tytygev/MN-82/справочная/arduino_pro_mini_pinout.gif

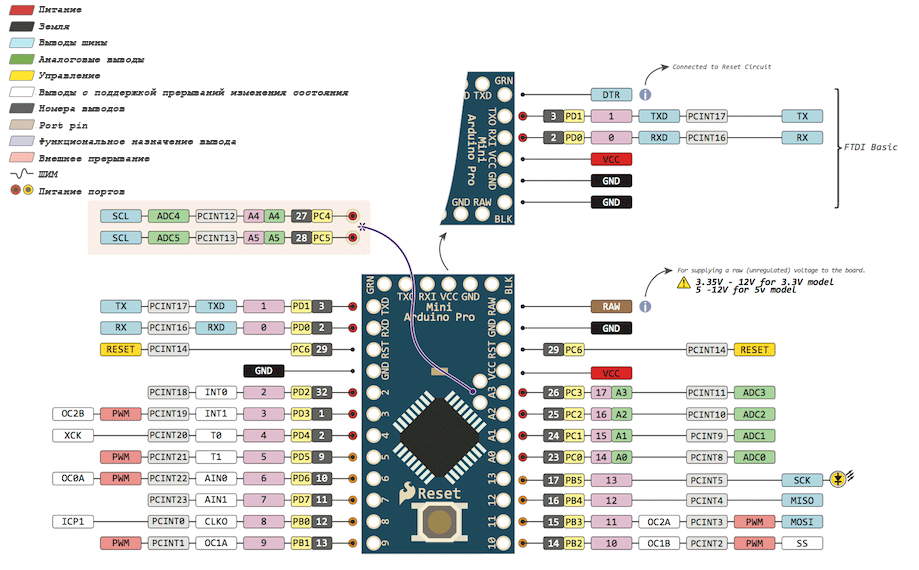
справочная/arduino_pro_mini_pinout.gif
