tytygev/MN-82/MN-82 theory.txt

Доработка радиоуправляемого автомобиля MN-82 на Ардуино Про мини 

Реализую схему управления световым оборудованием
Группы:
Фары (штатная проводка)
ГО задние (питаются от штатной проводки)
ПТФ
Стоп-сигналы
Правый повторитель поворота
Левый повторитель поворота
ЗХ

Ведомость модулей:
0- Штатная плата XL1986RT
1- ардуино с обвесом
2- питание DC5V + RC-модуль (RX480-E-WQ)
3- плата с резисторами для диодных сборк

Штатное питание: 7,4В
Питание ардуино и диодов: 5В. 
Расчётный ток на канал: до 200мА. 

Ввод:
• СИГНАЛЫ ОТ РАДИО МОДУЛЯ НАПРЯМУЮ
• ОТ ПИНОВ МОТОРА ЧЕРЕЗ ДЕЛИТЕЛЬ И ДИОД ЗЕНДЕРА

`
████████████████████████████████
█ Расчёт резисторов для диодов █
████████████████████████████████
`
Питание - 4.8

```
╔═╤═══╤═══════╤═════╤════╤══════╤═════╤═════╗
║◊│ V │ label │ Vcc │side│ A,mA │ R,Ом│Rn,Ом║
╟─┼───┼───────┼─────┼────┼──────┼─────┼─────╢
║ │4.8│ ЗХ    │ 2.7 │ П  │ 3x20 │ 35  │     ║
║ │   │       │     │ Л  │ 3x20 │ 35  │     ║
║ │   │       │     │both│ 6х20 │ 18  │     ║
╟─┼───┼───────┼─────┼────┼──────┼─────┼─────╢
║ │3.3│ ГОзад │ 1.9 │ П  │ 1x20 │ 69  │     ║
║ │   │       │     │ Л  │ 1x20 │ 69  │     ║
║ │   │       │     │both│ 2х20 │ --  │     ║
╟─┼───┼───────┼─────┼────┼──────┼─────┼─────╢
║ │4.8│ СС    │ 2.2 │ П  │ 2x20 │ 65  │     ║
║ │   │       │     │ Л  │ 2x20 │ 65  │     ║
║ │   │       │     │both│ 4х20 │ 32  │     ║
╟─┼───┼───────┼─────┼────┼──────┼─────┼─────╢
║ │4.8│ ППзад │ 2.2 │ П  │ 3x20 │ 43  │     ║
║ │   │       │     │ Л  │ 3x20 │ 43  │     ║
╟─┼───┼───────┼─────┼────┼──────┼─────┼─────╢
║ │4.8│ ППпер │ 2.2 │ П  │ 3x20 │ 43  │     ║
║ │   │       │     │ Л  │ 3x20 │ 43  │     ║
╟─┼───┼───────┼─────┼────┼──────┼─────┼─────╢
║ │4.8│ ППбок │ 1.8 │ П  │ 3x20 │ 50  │     ║
║ │   │       │     │ Л  │ 3x20 │ 50  │     ║
╟─┼───┼───────┼─────┼────┼──────┼─────┼─────╢
║ │4.8│ ПТФ   │ 3.0 │ П  │ 1x40 │ 45  │     ║
║ │   │       │     │ Л  │ 1x40 │ 45  │     ║
║ │   │       │     │both│ 2х40 │ 22  │     ║
╟─┼───┼───────┼─────┼────┼──────┼─────┼─────╢
║ │4.8│ ГС    │ 3.0 │ П  │ 1x30 │ 60  │     ║
║ │   │       │     │ Л  │ 1x30 │ 60  │     ║
║ │   │       │     │both│ 2х60 │ 30  │     ║
╚═╧═══╧═══════╧═════╧════╧══════╧═════╧═════╝
```

Падение напряжения на светодиодах
```
Цвет          │Vf, В
──────────────┼─────────
 Инфракрасный │ 1.9
 Красный      │ 1.6-2.0
 Оранжевый    │ 2.0-2.1
 Желтый       │ 2.1-2.2
 Зеленый      │ 2.2-3.5
 Синий        │ 2.5-3.7
 Фиолетовый   │ 2.8-4.0
 Белый        │ 3.0-3.7
 UV           │ 3.1-4.4
```
рабочий ток светодиода
Для стандартных 5 мм DIP-светодиодов на ножках, это величина обычно равна 20 мА.

`
██████████████████████
█ Управление диодами █
██████████████████████
`
ток до 200 мА на канал
питание 5В
управление по плюсу

лучшим решением является использование PNP биполярных транзисторов. Использование полевых (MOSFET) транзисторов здесь избыточно и усложнит схему, так как P-канальному полевику для полного открытия при 5В нужно так называемое «логическое управление» (Logic Level), а обычные копеечные транзисторы при 5В будут иметь высокое сопротивление.

Биполярный PNP-транзистор BC327-40 (в корпусе TO-92) 
или его SMD-аналог BC807-40 (в корпусе SOT-23) 
Он гарантированно выдерживает ток до 500 мА, коэффициент усиления (hFE) составляет от 250 до 600, что позволяет управлять им напрямую от пина Arduino.
```
                            +5V
                             │
                             ▼
                             │
                    ┌─[ R2 ]─┤   
                    │        │
                    │    ┌───┴───┐
                    │    │   E   │
                    │    │       │
 Arduino ──►─[ R1 ]─┴────┤ B     │
  Пин                    │       │
                         │   C   │
                         └───┬───┘
                             │
                             ▼
                       ┌───────────┐
                       │ Светодиод │
                       │  (Сборка) │
                       └─────┬─────┘
                             │
                             ▼
                           [ R3 ] (токоограничивающий резистор)
                             │
                             ▼
                            GND
```
Спецификация компонентов:

Транзистор: BC327-40 (выводной) или BC807-40 (SMD).
Распиновка BC327 (плоской стороной к себе): Слева направо: C (Коллектор), B (База), E (Эмиттер).
Резистор R1 (Базовый): 1 кОм. 
ток пина Arduino ~3,4 мА
Если будет BC327-25 — нужно подобрать базовый резистор меньшего номинала.
Резистор R2 (pull-up):  10кОм
Резистор R3 (Задающий яркость)

Логика работы (Инверсная): Чтобы светодиоды загорелись, Arduino должна выдать на пин LOW (ноль / земля). Чтобы светодиоды погасли, Arduino должна выдать на пин HIGH (+5V). 

Падение напряжения на транзисторе (Важно для R3!): В режиме насыщения при токе 200 мА падение напряжения между Эмиттером и Коллектором Vce у транзистора BC327 составляет 0.2В. На диодах будет не 5, а 4,8В.

`
███████████████████████████████
█ считывание данных с моторов █
███████████████████████████████
`
Универсальная схема 
(с фильтрацией ШИМ и защитой от выбросов)

Описание работы:
1.  Если ШИМ есть: Конденсатор сглаживает пульсации. Например, если ШИМ идет с заполнением 50% при 8В, то на проводе среднее напряжение будет 4В, а на пин Arduino (после делителя) придет стабильное значение около 1.28В.  
2.  Если ШИМ нет (чистый DC): Конденсатор никак не влияет на постоянный ток, схема работает точно так же, как и в прошлый раз.
3.  Защита от генерации: Стабилитрон и конденсатор работают в паре. Конденсатор берет на себя самые острые и короткие игольчатые импульсы от щеток мотора, а стабилитрон «срезает» лишнее напряжение, если мотор крутанули слишком сильно.

```
Провод X ───[10 kOm]──┬────┬────────┬─── Analog Pin A0
              (R1)    │    │        │   
              (R3)   ┌┴┐  ─┴─     ——┴——  
             4.7 kOm │ │  ─┬─C1     ▲    Стабилитрон D1 (4.7V) 1N4732A
                     └┬┘   │       / \   (Анод к GND, катод к A0)
                      │    │      ——┬—— 
                     GND  GND       │  
                         GND (Общая земля)

-------------------------------------------------------------------------

Провод Y ───[10 kOm]──┬────┬────────┬─── Analog Pin A1
              (R2)    │    │        │   
              (R4)   ┌┴┐  ─┴─     ——┴——  
             4.7 kOm │ │  ─┬─C2     ▲    Стабилитрон D2 (4.7V) 1N4732A
                     └┬┘   │       / \   (Анод к GND, катод к A1)
                      │    │      ——┬—— 
                     GND  GND       │  
                         GND (Общая земля)
```
Спецификация компонентов:
•  2 резистора по 10 кОм (R1, R2)
•  2 резистора по 4.7 кОм (R3, R4)
•  2 керамических или электролитических конденсатора на 0.1 мкФ или 1 мкФ (C1, C2)
•  2 стабилитрона на 4.7В (D1, D2)

 (проверка уровней):
Делитель рассчитан с коэффициентом k = 4.7 / (10 + 4.7) ≈ 0.32.
•  Когда на проводе 8В, на пин Arduino приходит: 8x0.32 = 2.56В.
•  Если мотор крутанули руками, и он выдал, например, 15В выброса: делитель попытался бы выдать 15 x 0.32 = 4.8В. В этот момент стабилитрон открывается и  удерживает напряжение на уровне 4.7В, спасая процессор.

`
█████████████████████████████
█ тахометр на датчике Холла █
█████████████████████████████
`
Датчик A3144 срабатывает на **южный полюс** магнита

Один важный нюанс, который отличает A3144 от многих других датчиков, — это **выход с открытым коллектором (open collector)**. Именно из-за него «голое» подключение может не заработать стабильно, и дело не в самом датчике, а в том, как Arduino читает его сигнал.

Внутри A3144 стоит транзистор, который соединяет выходной пин с землёй, когда видит магнит. Когда магнита нет, выход «висит в воздухе» (высокоимпедансное состояние). Чтобы Arduino могла чётко прочитать логическую единицу, этот «висящий» пин нужно **подтянуть к питанию** через резистор. Без этого пин будет ловить наводки, и `digitalRead()` может выдавать хаос вместо стабильного сигнала.

Технически, у Arduino Pro Mini есть **внутренний подтягивающий резистор** (~20–50 кОм), который включается командой `pinMode(pin, INPUT_PULLUP)` — именно эта команда уже стоит в твоём коде. **С ним датчик, скорее всего, заработает прямо на столе.** Однако внутренний резистор довольно «слабый» (высокое сопротивление), и в реальной модели, где рядом крутится мотор, искрят щётки и гуляют токи, он может не справиться с помехами. Поэтому **внешний резистор — это не обязательное, но крайне желательное усиление помехоустойчивости**.

Рекомендуемый «обвес» для датчиков стоящих на шасси рядом с силовой проводкой:
1.  Подтягивающий резистор 10 кОм между сигнальным пином и VCC 
    Это классическое решение для A3144. Он гарантирует, что в отсутствие магнита Arduino видит чёткую «1», а не наведённый шум.
2.  Керамический конденсатор 0.1 мкФ между сигнальным пином и GND
    Он работает как маленький фильтр, сглаживая высокочастотные помехи от мотора. 
	
Итоговая схема подключения для каждого датчика:
Нога 1 (VCC): к +5В.
Нога 2 (GND): к земле (GND).
Нога 3 (OUT): к пину Arduino (A1 или A2), и параллельно:
    *Резистор 10 кОм между этой ногой и +5В.
    *Конденсатор 0.1 мкФ между этой ногой и GND.

В коде команду `INPUT_PULLUP` можно оставить — она не помешает, а внешний резистор возьмёт на себя основную работу по подтяжке.

`
██████████████████████████████████████████
█ получение данных от внешнего приёмника █
██████████████████████████████████████████
`
RX480-E-WQ — это компактный 4-канальный беспроводной супергетеродинный радиоприемник, работающий на частоте 433 МГц (редко 315 МГц) с поддержкой кодировки EV1527. Он принимает сигналы от пультов ДУ и выдает управляющие сигналы на четырех независимых цифровых выходах (D0–D3).
Согласование не требуется.

Характеристики и распиновка
Напряжение питания: от 3,0 В до 5,0 В постоянного тока.
Частота: 433,92 МГц (или 315 МГц).
Выходы: 4 канала (D0, D1, D2, D3) с логическим уровнем.
вывод VT (выход индикации статуса приема, выдает HIGH, когда нажата любая кнопка на пульте)
Питание и земля: контакты +V (VCC) и GND.
Антенна: контакт для припайки куска провода (обязателен для стабильного приема).

Режимы работы и настройка
Модуль поддерживает три основных режима работы, которые переключаются кнопкой обучения (Learning Key) на плате:

Импульсный режим (Inching / Momentary): сигнал на выходе D держится только пока зажата кнопка на пульте.
Настройка: нажмите кнопку обучения 1 раз, дождитесь загорания светодиода, затем нажмите кнопку на пульте.

Режим с фиксацией (Self-locking / Toggle): первое нажатие включат канал (высокий уровень), повторное — выключает.
Настройка: нажмите кнопку обучения 2 раза, затем нажмите кнопку на пульте.

Режим блокировки (Interlocking): при включении одного канала другой активный канал выключается.
Настройка: нажмите кнопку обучения 3 раза, затем нажмите кнопку на пульте.Сброс памяти: нажмите кнопку обучения 8 раз, чтобы очистить все привязанные пульты.

`
██████████████
█  ПРОШИВКА  █
██████████████
`
USB-UART на CP2102

Распиновка Pro Mini (обычно 6-контактный разъём для программирования)

• VCC – питание (5 В для вашей версии)
• GND – общий
• RXI (или RX) – вход последовательного порта (подключается к TXD адаптера)
• TXO (или TX) – выход последовательного порта (подключается к RXD адаптера)
• DTR (или GRN) – управление сбросом (если есть отдельный пин)
• RESET – можно использовать при отсутствии DTR

Подключение CP2102 → Pro Mini
```
╔════════╤══════════╤═══════════════════════════════════════════════════════╗
║ CP2102 │ Pro Mini │ Примечание                                            ║
╟────────┼──────────┼───────────────────────────────────────────────────────╢
║ TXD    │ RXI (RX) │ Передача данных от адаптера к микроконтроллеру        ║
║ RXD    │ TXO (TX) │ Приём данных от микроконтроллера                      ║
║ GND    │ GND      │ Обязательно общий провод                              ║
║ +5V    │ VCC      │ Питание Pro Mini от USB (если нет внешнего питания)   ║
║ DTR    │ DTR / GRN│ Если есть выделенный пин DTR/GRN, подключайте напрямую║
║ или    │          │                                                       ║
║ DTR    │ RESET    │ через конденсатор 0.1 мкФ (100 нФ)  Если нет пина DTR,║
║        │          │ используйте конденсатор для автосброса                ║
╚════════╧══════════╧═══════════════════════════════════════════════════════╝
```
Важно: не подключайте вывод 3V3 к 5В плате Pro Mini — это может вывести её из строя. 
Все остальные сигналы (DCD, DSR, RTS, CTS, RST, R1, SUS) не используются, оставьте их неподключёнными.
Автосброс

Для загрузки скетча Arduino IDE автоматически переключает линию DTR, что через конденсатор создаёт импульс сброса на RESET Pro Mini. Если у вас на Pro Mini есть отдельный пин DTR (часто помечен как GRN), соединение напрямую будет работать без дополнительного конденсатора, т.к. на плате уже предусмотрен конденсатор.
Если же вы подключаете DTR к RESET, обязательно поставьте конденсатор 0.1 мкФ (керамический, полярность не важна). Без него сброс может происходить некорректно или вообще не срабатывать.

> Настройка Arduino IDE
>> Подключите адаптер к USB-порту компьютера.
>> В Arduino IDE выберите:
>>> Инструменты → Плата → Arduino Pro or Pro Mini
>>> Процессор → ATmega168P (5V, 16 MHz) (или аналогичный с пометкой 168P)
>> Выберите порт, который появится в Инструменты → Порт (обычно COMx).
> Нажмите «Загрузка».

Если загрузка не удаётся
- Проверьте, что TXD адаптера соединён именно с RXI Pro Mini, а RXD — с TXO (перекрёстно).
- Убедитесь, что GND общий.
- Попробуйте нажать кнопку RESET на Pro Mini сразу после нажатия кнопки «Загрузка» в Arduino IDE (если нет автосброса).
- Проверьте, что питание 5 В подаётся на VCC Pro Mini (если плата не питается отдельно).
- Если прошивка зависает на «Uploading...», возможно, не работает DTR. Тогда вручную удерживайте RESET, запустите загрузку и отпустите RESET через пару секунд.

После этих шагов скетч должен успешно загрузиться в вашу Pro Mini.

`
████████████████████████████████████
█ ТАЙМИНГИ НА ПОВОРОТНИКИ/АВАРИЙКУ █
████████████████████████████████████
`
Согласно ГОСТ Р 41.48 (Правила ЕЭК ООН № 48), соотношение времени работы и паузы должно быть стабильным:
• Свет горит: от 40% до 60% времени одного полного цикла.
• Свет погашен: от 40% до 60% времени одного полного цикла.
Если перевести это в секунды для стандартной частоты (возьмем средние 90 миганий в минуту, где один полный цикл «вспышка + пауза» длится около 0,66 секунды):
• Время свечения: примерно 0,27–0,40 секунды.
• Время темноты: примерно 0,27–0,40 секунды.
Вспышка и пауза на исправном автомобиле визуально должны быть практически одинаковыми по длительности. При первом включении аварийной сигнализации световой сигнал должен загореться не позднее чем через 1 секунду.

`
████████████████████████████████████████
█ Модификация питания и автоотключения █
████████████████████████████████████████
`
1. Общая концепция и логика работы
Система предназначена для полного обесточивания штатной платы (XL1986RT), Arduino Pro Mini, радиоприемника (RX480-E-WQ) и DC-DC преобразователя по истечении заданного времени бездействия. 

Ключевая особенность:
Повторный запуск возможен только после перевода выключателя в положение OFF и обратно в ON. Быстрое «передергивание» (менее 0.5 сек) не сработает, если не установлен диод быстрого разряда (см. пункт 3).

Логика по состояниям:
(1) Включение (Switch ON):
    Питание 7.4В подается на Исток P-MOSFET (Q1). Конденсатор C2 разряжен, Затвор Q1 = 0В. Q1 открывается. Arduino стартует, подает HIGH на пин PIN_HOLD. Транзистор Q2 открывается и прижимает Затвор Q1 к земле, удерживая систему включенной.

(2) Рабочий режим:
    Штатная плата работает от 7.4В. Arduino и RX480 работают от 5В (DC-DC). Arduino управляет светом и моторами.

(3) Автоотключение (по таймауту): 
    Arduino подает LOW на PIN_HOLD. Q2 закрывается. Резистор R2 (1 МОм) плавно заряжает C2, подтягивая Затвор Q1 к Истоку (7.4В). Q1 закрывается. Питание 7.4В полностью пропадает со всей системы. Потребление от батареи = 0А.

(4) Сброс (Switch OFF -> ON): 
    При переводе в OFF центральный контакт кнопки соединяется с левым (GND). Исток Q1 садится на землю. Затвор Q1 (заряженный) через диод D1 мгновенно разряжается на землю. При переводе в ON система запускается с нуля.

2. Спецификация элементов (BOM)

```
╔════╤════════════════════╤══════════════════════════╤════════════════════════════════════╗
║ П. │     Компонент      │   Номинал / Маркировка   │             Примечание             ║
╠════╪════════════════════╪══════════════════════════╪════════════════════════════════════╣
║ Q1 │ P-канальный MOSFET │ IRF9Z34N                 │ Корпус TO-220. Обязательно         ║
║    │                    │ (или аналог Logic-Level) │ Logic-Level (открывается при 4-5В) ║
║ Q2 │ NPN Транзистор     │ 2N3904 (или BC547,S8050) │ Корпус TO-92                       ║
║ D1 │ Диод               │ 1N4148 (или 1N4007)      │ Для быстрого разряда C2            ║
║ R1 │ Резистор           │ 10 кОм (1/4 Вт)          │ Разрядный резистор для левого      ║
║    │                    │                          │ контакта кнопки                    ║
║ R2 │ Резистор           │ 1 МОм (1/4 Вт)           │ Подтяжка Затвора Q1 к Истоку       ║
║ R3 │ Резистор           │ 1 кОм (1/4 Вт)           │ Базовый резистор Q2                ║
║ C2 │ Конденсатор        │ 100 мкФ x 16В            │ Электролитический.                 ║
║    │                    │                          │ Обеспечивает задержку старта       ║
╚════╧════════════════════╧══════════════════════════╧════════════════════════════════════╝
```
3. Описание соединений (Pin-to-Pin)

□ Силовая часть (7.4В)
Батарея B+ -> Правый контакт выключателя (Pin 3)
Правый контакт выключателя (Pin 3) -> Исток (Source) Q1
Сток (Drain) Q1 -> Питание штатной платы XL1986RT (7.4В) + Вход Vin DC-DC
Батарея GND -> GND штатной платы, GND DC-DC, GND Arduino, GND RX480

□ Выключатель (SPDT, 3 контакта)
Правый (Pin 3) -> B+ батареи
Центральный (Pin 2) -> Исток (Source) Q1
Левый (Pin 1) -> Резистор R1 (10 кОм) -> GND

□ Узел удержания и задержки (Затвор Q1)
Затвор (Gate) Q1 -> Резистор R2 (1 МОм) -> Исток (Source) Q1
Затвор (Gate) Q1 -> Плюсовая ножка конденсатора C2 (100 мкФ). Минусовая ножка -> GND
Затвор (Gate) Q1 -> Коллектор NPN-транзистора Q2
Затвор (Gate) Q1 -> Анод диода D1
Катод диода D1 -> Исток (Source) Q1 (то есть параллельно R2)

□ Управление от Arduino
Arduino PIN_HOLD (любой цифровой пин) -> Резистор R3 (1 кОм) -> База NPN-транзистора Q2
Эмиттер NPN-транзистора Q2 -> GND

□ Питание логики (5В)
DC-DC Vin -> Сток (Drain) Q1
DC-DC GND -> GND
DC-DC 5V Out -> Arduino VCC, RX480 VCC
DC-DC En -> Перемычка на Vin (см. важное примечание 1)

4. Важные примечания для реализации

★ Защита пина En DC-DC: 
   Если ваш модуль DC-DC не рассчитан на подачу 8.4В напрямую на пин En (максимум обычно 5-6В), не соединяйте En с Vin напрямую. Поставьте делитель напряжения: резистор 10 кОм от Vin к En и резистор 20 кОм от En к GND. Это снизит напряжение на En до безопасных ~5.6В при полном заряде батареи.

★ Логика скетча Arduino:
   *В блоке setup(): Сразу подать HIGH на PIN_HOLD (чтобы удержать питание после загрузки).
   *В блоке loop(): Отслеживать таймер бездействия. При достижении таймаута подать LOW на PIN_HOLD.

★ Нагрев Q1:
   IRF9Z34N рассчитан на ток до 19А. Если моторы потребляют большой ток (например, при заклинивании), MOSFET может греться. Рекомендуется установить небольшой радиатор

★ Диапазон напряжений:
   Схема работоспособна от 4В до 9В. При 4-5В убедитесь, что DC-DC справляется с выдачей 5В и 300 мА. При 8-9В следите за нагревом DC-DC и защитой пина En.

`
████████████████████████████████████
█ Описание библиотеки PowerManager █
████████████████████████████████████
`
Логика архитектуры
	Интерфейс и конфигурация
		Класс PowerManager
			В конструкторе класса предусмотрена передача всех пинов и их активных уровней
			Неограниченное количество пинов с разными уровнями: реализуем через передачу массива структур InputPin в конструктор.		
			Время таймаута в миллисекундах.

	Реализация логики ввода/вывода
		Метод инициализации begin() — настраивает пины и сразу подает активный уровень на PIN_HOLD для фиксации питания.
		Метод update() — вызывается в основном цикле loop(). Он будет опрашивать входы. Если зафиксирован активный сигнал (с учетом заданного уровня), таймер сбрасывается.

	Логика таймера и состояния 
		Внутренний учет времени через millis().
		Если в течение заданного времени update() не фиксирует активности, класс переходит в состояние подготовки к выключению.
		Реализация метода shutdown() — переводит пин удержания в неактивный уровень (LOW) и, при необходимости, вызывает пользовательский коллбэк.

	Структура файлов (Разделение для переиспользования)
		PowerManager.h — декларация класса, интерфейсы, конфигурация.
		PowerManager.cpp — реализация методов, работа с millis(), чтение пинов и управление выходом.
		В основном .ino файле создание экземпляра класса с нужными настройками и вызов двух методов: power.begin() в setup() и power.update() в loop().

пример использования: 

#include "PowerManager.h"

// Настройки пинов
#define PIN_HOLD D13
#define PIN_RC   D12
#define PIN_HALL_1 A1
#define PIN_HALL_2 A2

// Конфигурация входов
// 1. RC-модуль: активный HIGH, обычный INPUT
// 2. Датчики Холла: активный LOW, INPUT_PULLUP (чтобы не висел в воздухе)
const InputPin inputs[] = {
  {PIN_RC,     HIGH, INPUT},
  {PIN_HALL_1, LOW,  INPUT_PULLUP},
  {PIN_HALL_2, LOW,  INPUT_PULLUP}
};
const uint8_t inputCount = sizeof(inputs) / sizeof(inputs[0]);

// Настройки питания: удержание HIGH на D13, таймаут 5 минут (300000 мс)
PowerManager power(PIN_HOLD, HIGH, inputs, inputCount, 300000);

// (Необязательно) Коллбэк для выполнения перед выключением
void onPowerOff() {
  // Например, выключить свет или мигнуть фарами
  // digitalWrite(PIN_LIGHTS, LOW);
}

void setup() {
  // Инициализация менеджера питания должна быть ПЕРВОЙ
  power.setShutdownCallback(onPowerOff);
  power.begin();

  // ... остальная инициализация ...
}

void loop() {
  // Опрос датчиков и таймера
  power.update();

  // ... основной код ...
}

─│┌┐└┘├┤┬┴┼═║╒╓╔╕╖╗╘╙╚╛╜╝╞╟╠╡╢╣╤╥╦╧╨╩╪╫╬█░▒▓▲►▼◄
