tytygev/MN-82/MN-82 KeyHoldPower with DC5v_схема.png

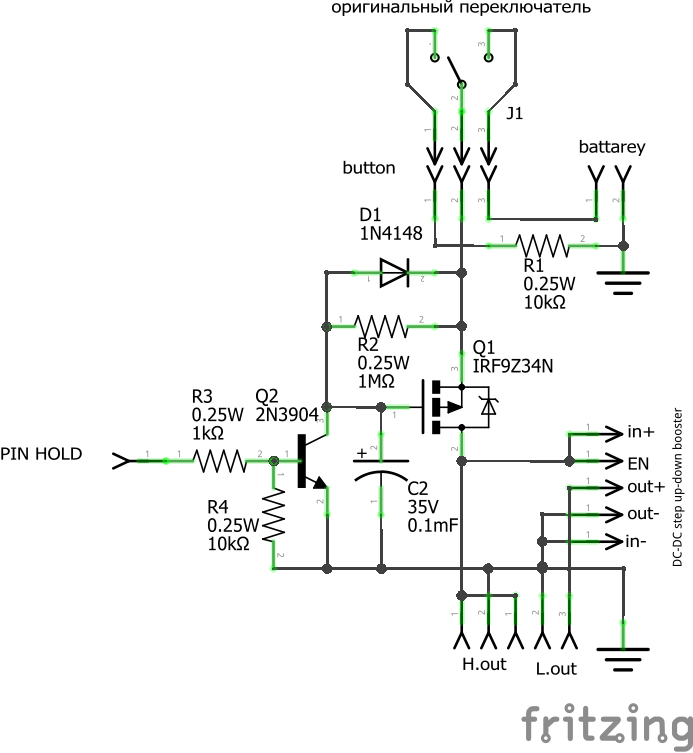
MN-82 KeyHoldPower with DC5v_схема.png
