tytygev/MN-82/MN-82 UPG A-Sheeld v.0.4_схема.png

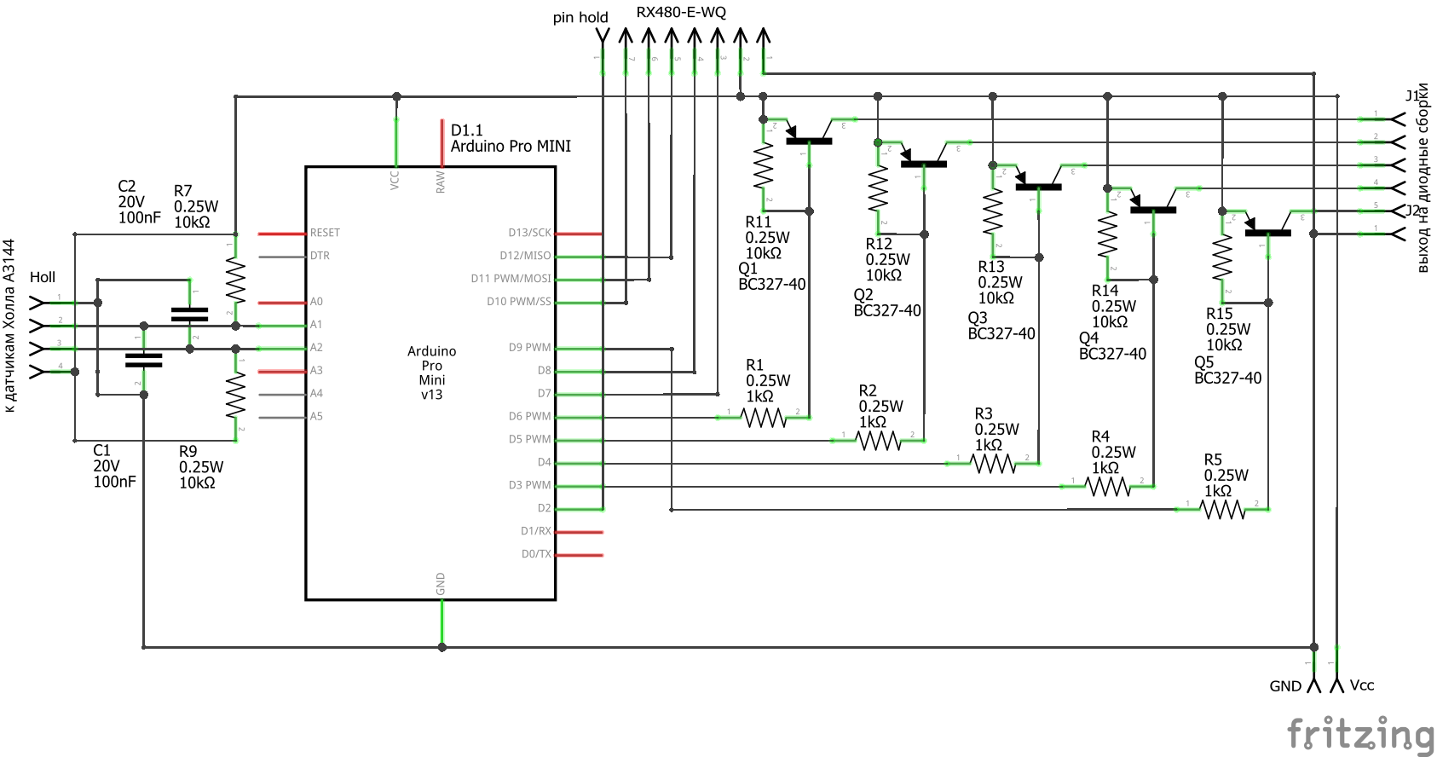
MN-82 UPG A-Sheeld v.0.4_схема.png
