tytygev/MN-82/Screenshot_1.png

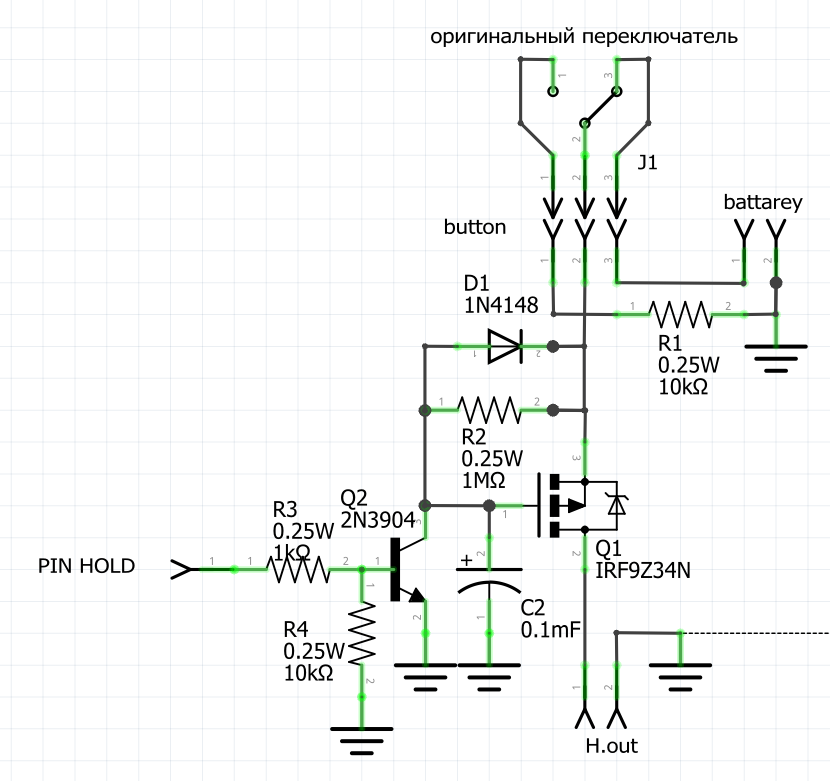
Screenshot_1.png
