tytygev/MN-82/модуль на ардуино.png

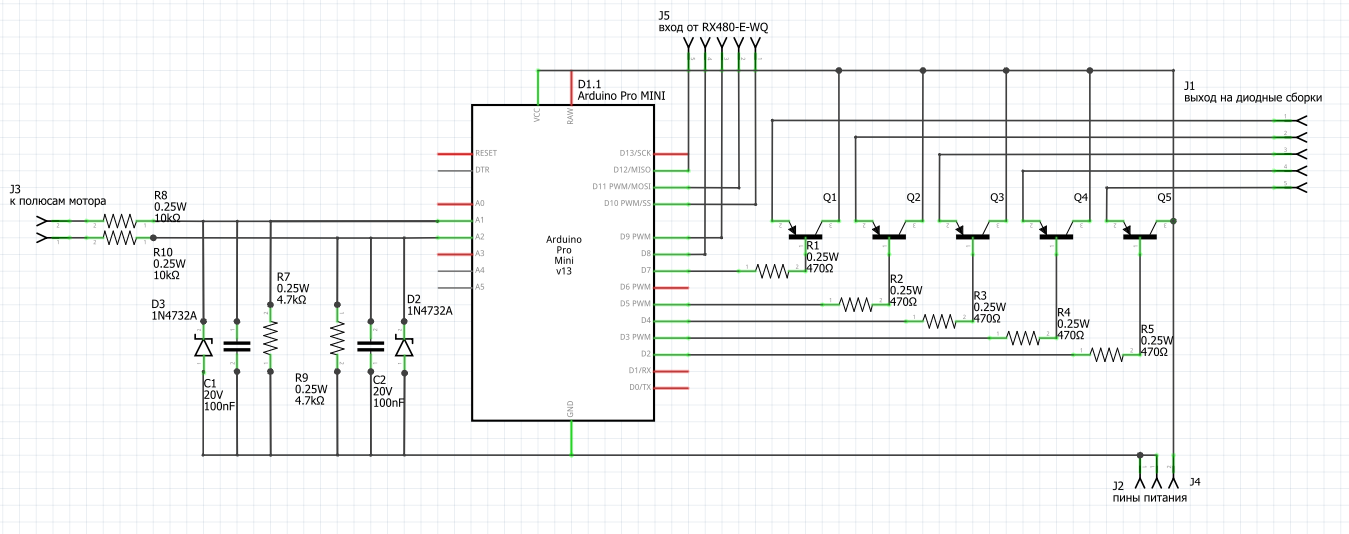
модуль на ардуино.png
