tytygev/MN-82/справочная/mosfet-to220-p-ch.png

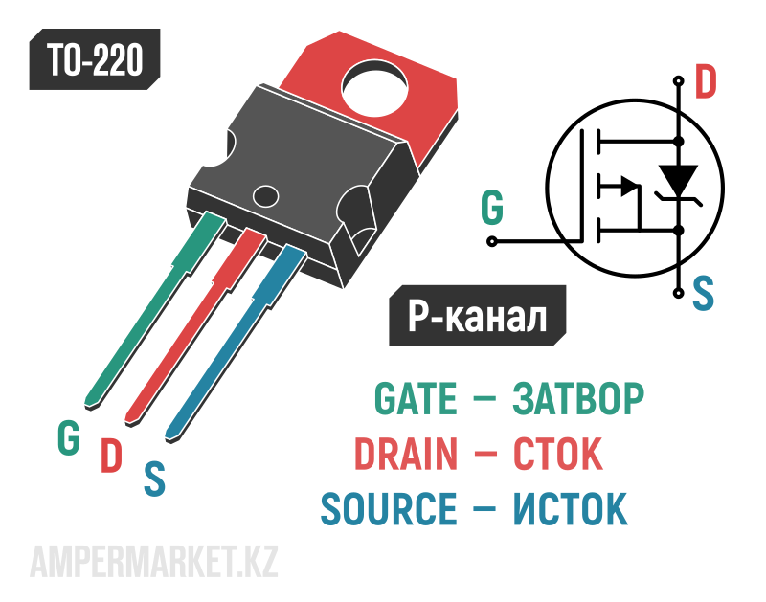
справочная/mosfet-to220-p-ch.png
