tytygev/MN-82/справочная/tranzistor-bc327-40-cb5203c.jpg

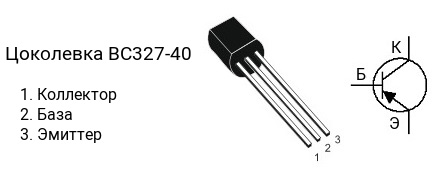
справочная/tranzistor-bc327-40-cb5203c.jpg
