tytygev/MN-82/part models/support Hall Detector A3144 v2.stl

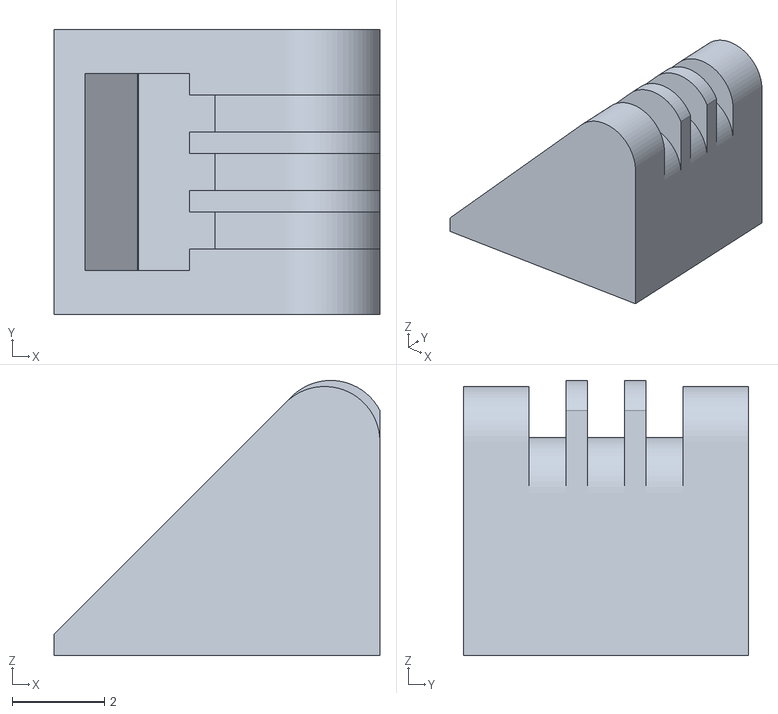
[picture p8: CAD file, 2026-11-09]
part models/support Hall Detector A3144 v2.stl
7.06 x 6.17 x 5.96
