tytygev/MN-82/(list of files, cad)

Other CAD files:
part models/support Hall Detector A3144.stl
part models/support Hall Detector A3144 v2.f3d
part models/support Hall Detector A3144.f3d
