tytygev/MN-82/MN-82 KeyHoldPower_схема.pdf

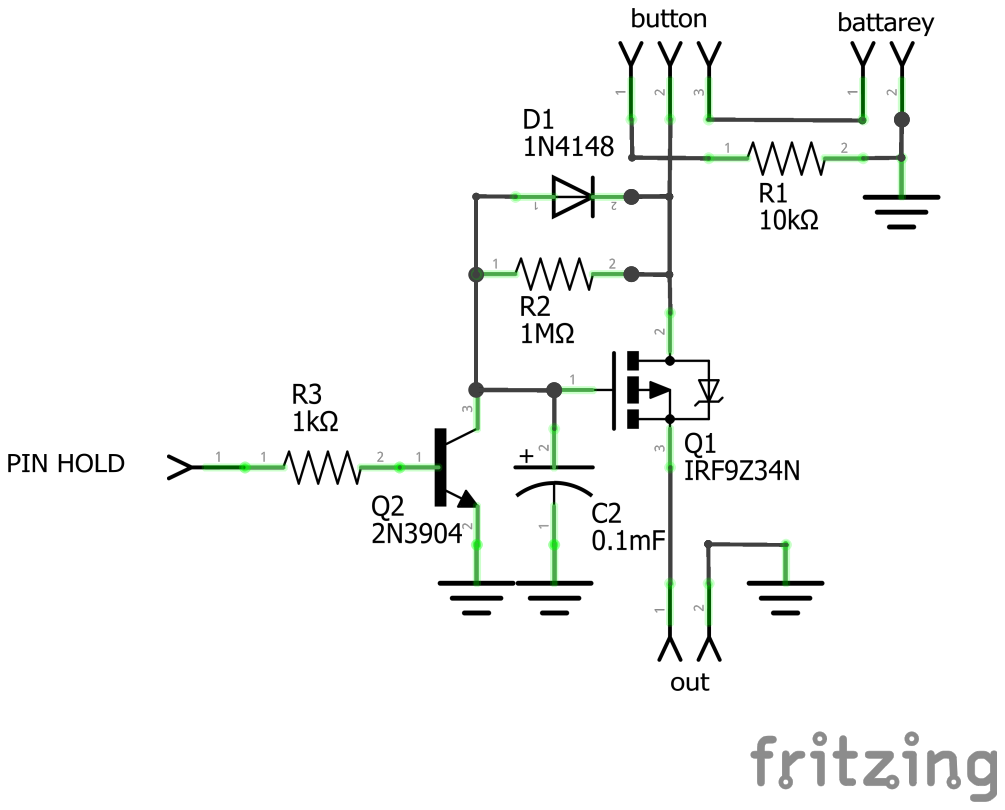
[picture p9: page 1]
