tytygev/MN-82/MN-82 UPG A-Sheeld версия с подтяжкой эмитера на печатке_схема.pdf

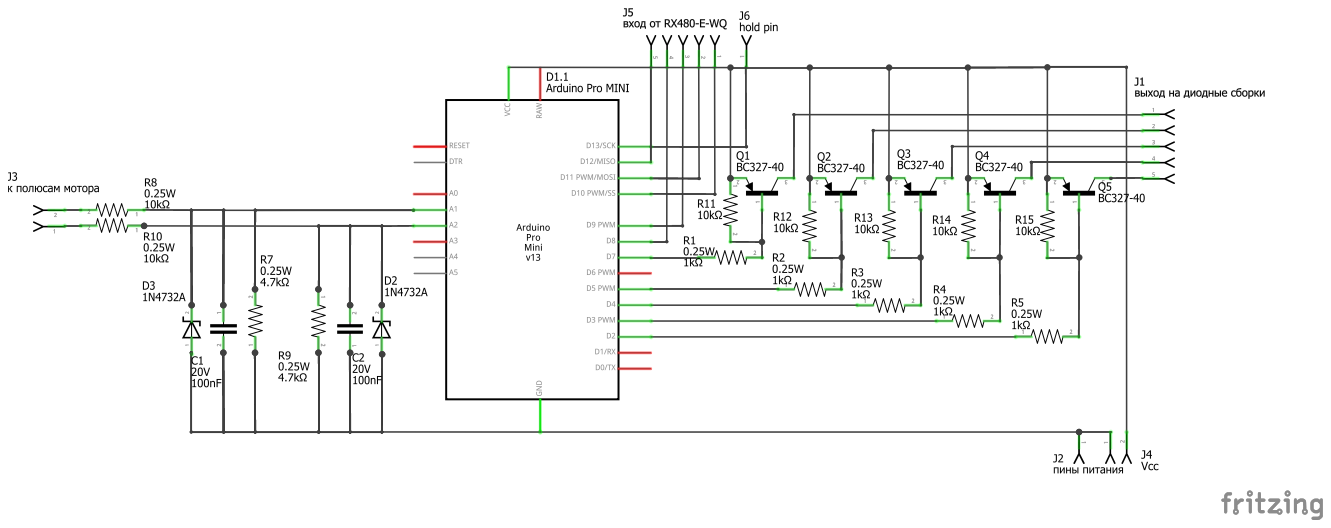
[picture p10: page 1]
