tytygev/MN-82/(list of files, drawings)

Other design files:
MN-82 KeyHoldPower with DC5v.fzz
MN-82 KeyHoldPower.fzz
MN-82 UPG A-Sheeld v.0.3 (на тахометре).fzz
MN-82 UPG A-Sheeld v.0.4.fzz
MN-82 UPG A-Sheeld версия с подтяжкой эмитера на печатке.fzz
MN-82 UPG A-Sheeld.fzz
