tytygev/MN-82/(commit log)

2026-08-30 половину переписали
2026-09-06 корректировка логики поворотников
2026-09-06 обновление файла с инфой. +gitignore
2026-09-07 переназначение портов
2026-09-15 редакционные правки
    [MN-82 UPG A-Sheeld-1.fzz, MN-82 UPG A-Sheeld.fzz]
2026-09-15 новая схема управления питанием
    [MN-82 KeyHoldPower.fzz]
2026-10-04 обновление игнора и записок
2026-10-04 доработка заметок
2026-10-07 редактирование, косяки
    [MN-82 UPG A-Sheeld.fzz]
2026-10-08 обновленная схема
    [MN-82 UPG A-Sheeld.fzz]
2026-10-08 схема с обновленной топологией
    добавлены подтягивающие базу к эмиттеру
    [MN-82 UPG A-Sheeld версия с подтяжкой эмитера на печатке.fzz]
2026-10-08 редактирование заметок. переименование файла шаблона скетча
2026-10-08 обновление. копия схемы для ключа питания
    [MN-82 KeyHoldPower - реинтеграция stab dcdc - RC module.fzz]
2026-10-09 Доработка топологии, переименование файла
    KeyHold и питание 5в на одной плате
    [MN-82 KeyHoldPower - реинтеграция stab dcdc - RC module.fzz, MN-82 KeyHoldPower with DC5v.fzz]
2026-10-09 добавлена схема блока коммутации диодных сборок
2026-10-11 таблица с расчётами резисторов новая
2026-10-12 переназначение пинов
2026-10-12 мув скетч в папку для arduinoIDE
    обновление гитигнор
2026-10-13 редактирование параметров, внесение комментариев о проблемах
2026-10-15 инструкция по логам
2026-10-15 выполнение 3х задач:
    логи для детектора, фикс блинкера и фикс огней реверса
2026-10-15 доработка логики стоп-сигналов
2026-10-15 fix ошибок определений
2026-10-15 правка логики stop-lights
2026-10-15 правка логики: переход на предварительную фильтрацию ШИМ
2026-10-15 Настройки, расширение лога
2026-10-15 замена на квадратичную функцию, настройки параметров
2026-10-15 ещё правки алгоритма фильтрации ШИМ, настройки
2026-10-15 добавление трендов, переписали класс, замениели константы
2026-10-18 справочно-технические файлы
2026-10-19 Добавлена моделька держателя для датчика Холла
2026-10-20 переход на тахометр.
    детектирование напряжение убрали
2026-10-20 Обновление информации в заметках
2026-10-20 Add Схема и Макетка на тахометре
2026-10-21 обновление схемы KeyHoldPower
2026-10-21 add lib PowerManager + upd doc
2026-10-22 изменения в распиновке, коррекция ПП
2026-10-23 add PWM Output Controller library
2026-10-25 доработка тахометра и контролов
2026-10-25 редакторские правки платы
2026-10-25 рефакторинг. без тестов на компиляцию
2026-10-25 пост мердж рефакторинг
2026-10-26 чистка, реорганизация файлов, наведение порядка. никакого кода
2026-10-27 реорганизация, справочная инфа, редактура заметок.
    никакого кода
2026-10-27 переименование файлов
2026-11-01 корректировка схем и ПП
2026-11-03 Корректировка ПП
2026-11-03 Редакторские правки под новую топологию ПП
2026-11-08 корректировка макетки
2026-11-09 Правка ПП
2026-11-09 обновление модели суппорта для датчика
